topherCantrell/ZoeBoard/README.md

# Zoe Board

The Neo Pixel Processor Board

Named after the Golden Hurricane students who inspired it.

## Links
  - [Construction](Construction.md)
  - [Zoe Virtual Machine](Zoe.md)
  - [Zoe Programming Language](ZoeLanguage.md)

## Hardware

Schematic:

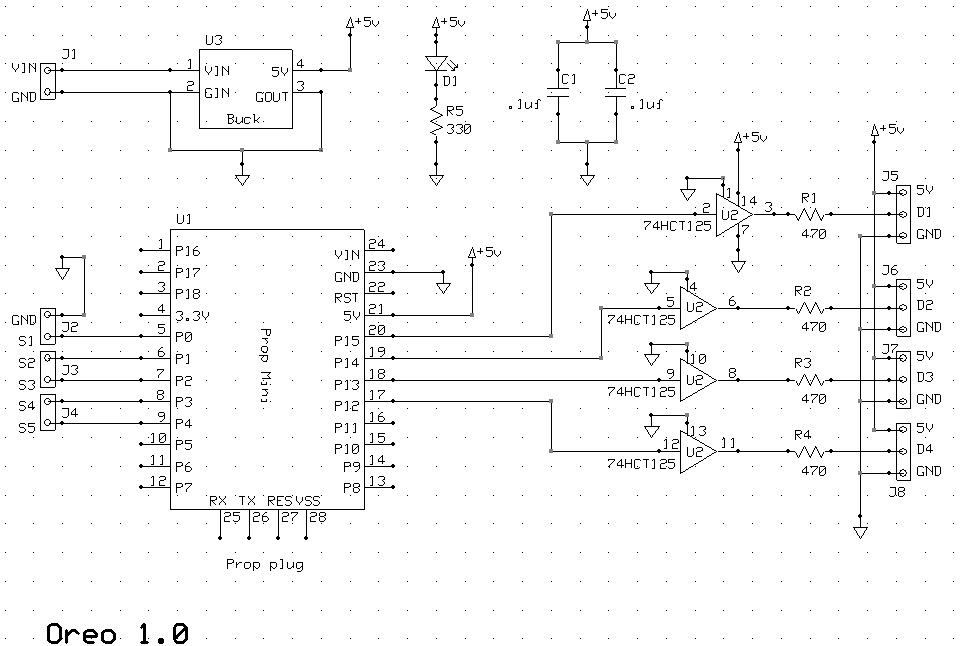
[picture p1: art/ZoeSCH.jpg]


PCB:

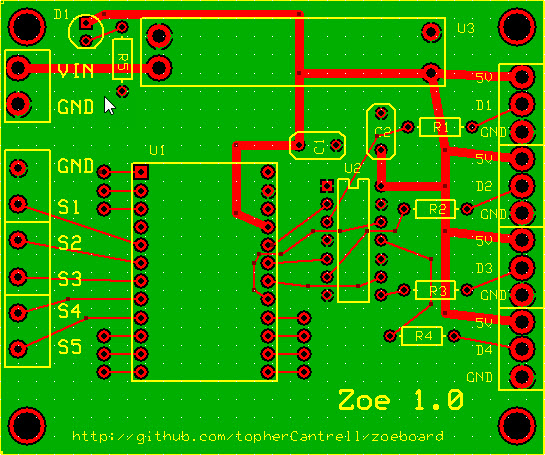
[picture p2: art/ZoePCB.jpg]


MXP on the RoboRIO:

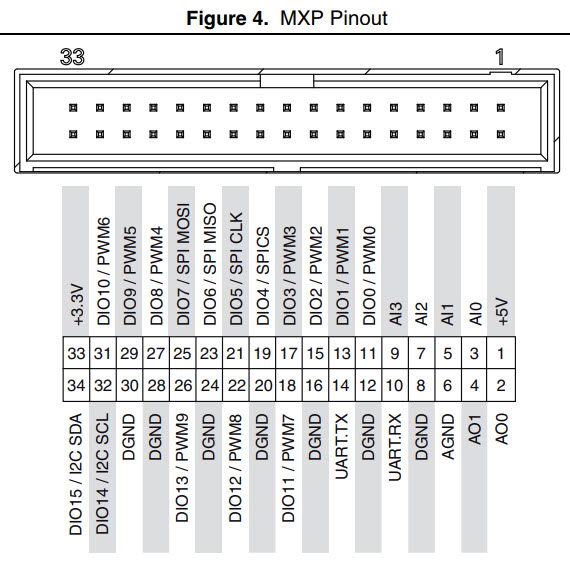
[picture p3: art/MXP.jpg]


## 2017

Every year is a new robot! Here are the [specifics for the 2017 robot](https://github.com/team5858/zoeboard/tree/master/2017).
