topherCantrell/ZoeBoard/(list of files, drawings)

Other design files:
oreo.pcb
